joeperri95/Capstone/Arduino/Dispension/Dispension.ino

#include <QTRSensors.h>

int pump1 = 9; //Orange Juice
int pump2 = 10; //Ginger Ale
int r = 0; //Recieved Order

QTRSensors qtr;
const uint8_t SensorCount = 1;
uint16_t sensorValues[SensorCount];

void setup() {
  Serial.begin(9600);
  pinMode(pump1,OUTPUT);
  pinMode(pump2,OUTPUT);

  digitalWrite(pump1,LOW);
  digitalWrite(pump2,LOW);

  qtr.setTypeRC();
  qtr.setSensorPins((const uint8_t[]){3}, SensorCount);
  
}

void loop(){
  if(Serial.available()){        //make sure we have serial connection
    r = Serial.read() - '0';     //convert incoming ASCII to integer
    
    if (r == 1){
      Serial.write(r+1);         // each if sends a recieve echo
      oj();                      // then dispenses drink
    }
    
    if(r == 2){
      Serial.write(r+2);
      ga();
      
    }
    
    if(r == 3){
      Serial.write(r+3);
      mimosa();
      
    }
    
    else{  
      Serial.write(-1);          // sends back a -1 if there are errors
    }
  }
}


void oj(){
  delay(5000);
  qtr.read(sensorValues);
  if(sensorValues[0] < 2000){
    digitalWrite(pump1,HIGH);
    delay(32000);
    digitalWrite(pump1,LOW);
    Serial.write(5);
  }
  else{
    Serial.write(-2);
  }
}


void ga(){
  delay(5000);
  qtr.read(sensorValues);
  if(sensorValues[0] < 2000){
    digitalWrite(pump2,HIGH);
    delay(60000);
    digitalWrite(pump2,LOW);
    Serial.write(5);
  }
  else{
    Serial.write(-2);
  }
}

void mimosa(){
  delay(5000);
  qtr.read(sensorValues);
  if(sensorValues[0] < 2000){
    digitalWrite(pump1,HIGH);
    digitalWrite(pump2,HIGH);
    delay(24000);
    digitalWrite(pump1,LOW);
    digitalWrite(pump2,LOW);
    Serial.write(5);
  }
  else{
    Serial.write(-2);
  }
}
