joeperri95/Capstone/(commit log)

2019-01-10 Created Elevator.py
    Added code to drive the elevator motor
2019-03-02 Motor Driver
2019-03-02 Finished About the Project Section
    Added in embeded about project pdf into the website. currently holds the progress report
2019-04-01 restructure directory, offload dispension to arduino
2019-04-01 updated navigator to set motor speed
2019-04-01 Arduino Code
    Initial arduino code commit
2019-04-02 dispensor fix removed timeout
    [Dispensor.py]
2019-04-04 Currently Serving
2019-04-04 created motor test
2019-04-04 fixed bug to make motors work
    [Bot.py, Motors.py]
2019-04-04 upped motor speed
2019-04-08 added LEDmanager classes removed motors
2019-04-09 fixed to allow running
    [Navigator.py, Robot.py]
2020-09-03 import utils to fix linter error
    [Dispensor.py]
